flo199213/ShyGuy/Images/Back.jpg

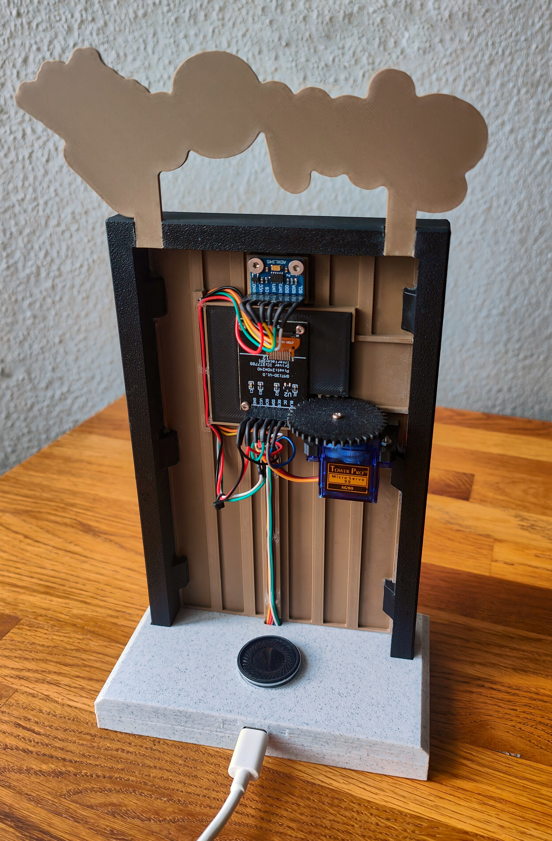
Images/Back.jpg
