flo199213/ShyGuy/Images/BackDetail.jpg

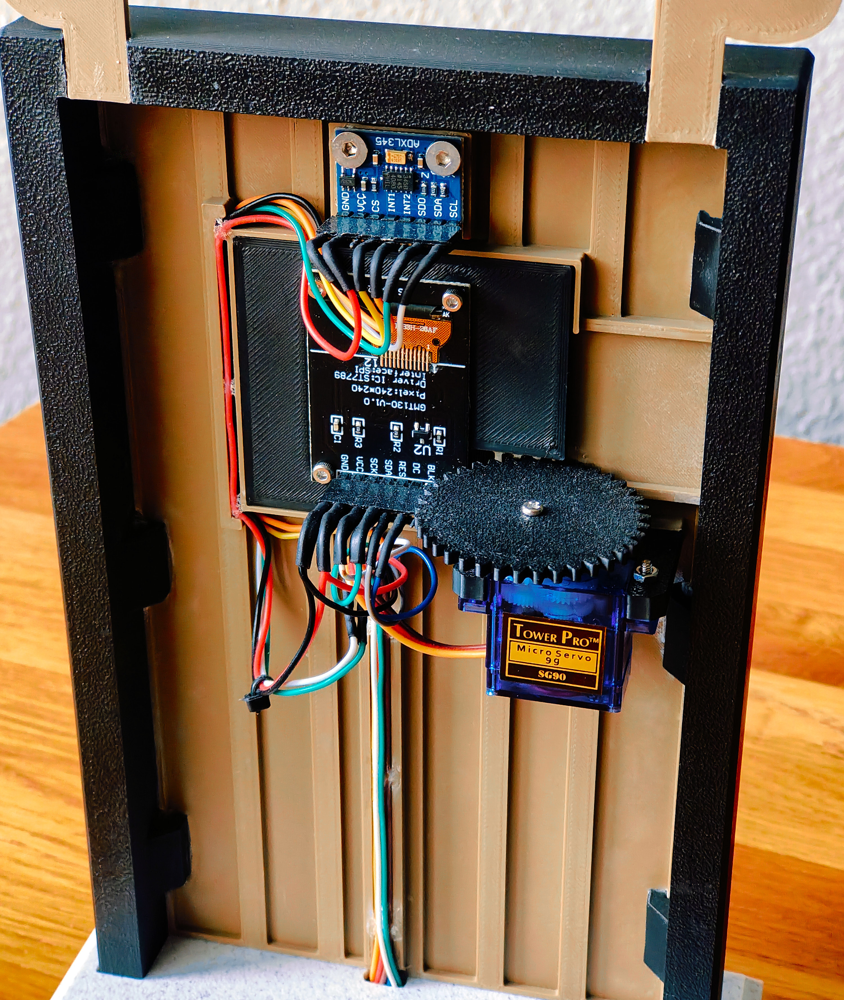
Images/BackDetail.jpg
