flo199213/ShyGuy/Images/Cults.jpg

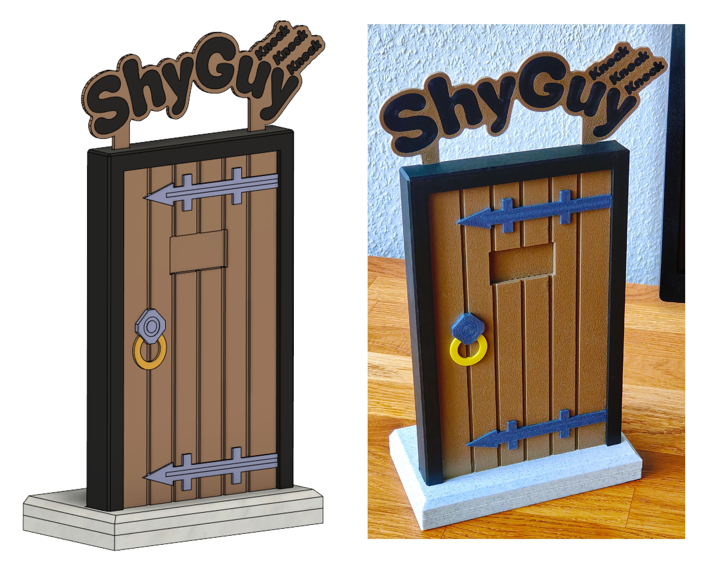
Images/Cults.jpg
