flo199213/ShyGuy/Images/Front.jpg

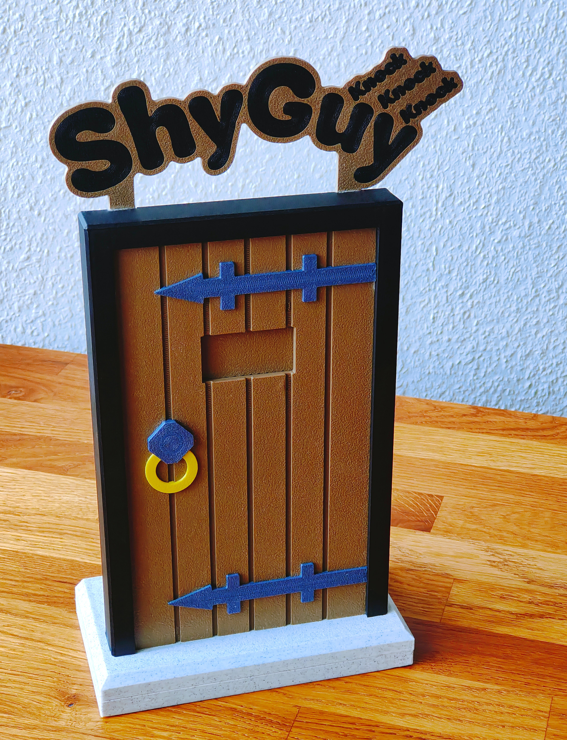
Images/Front.jpg
