flo199213/ShyGuy/Images/FrontWithMonitor2.jpg

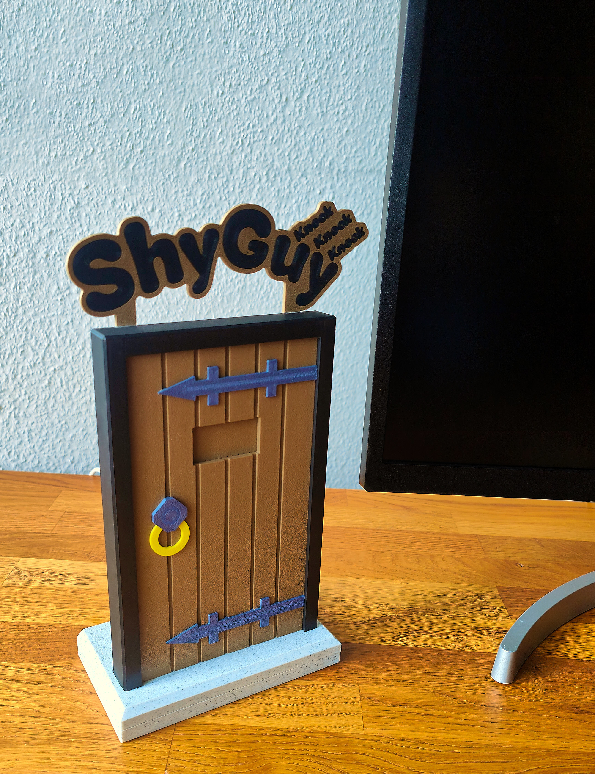
Images/FrontWithMonitor2.jpg
