flo199213/ShyGuy/Images/FrontWithMonitor.jpg

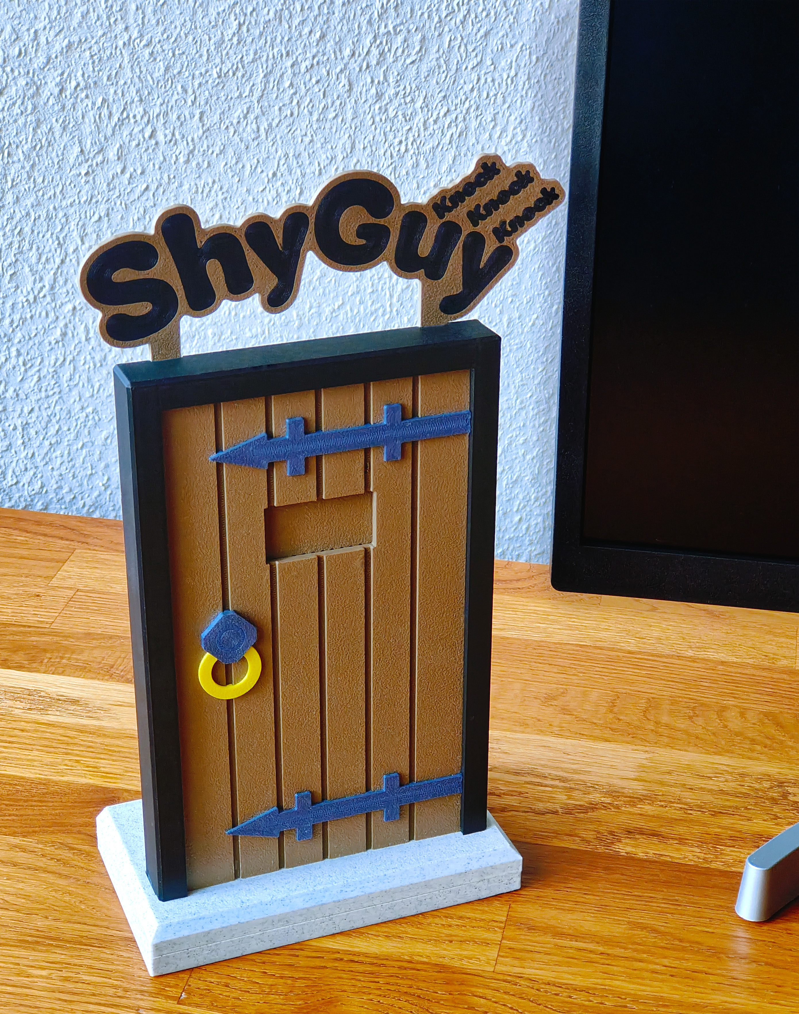
Images/FrontWithMonitor.jpg
