flo199213/ShyGuy/Images/Mechanism5.png

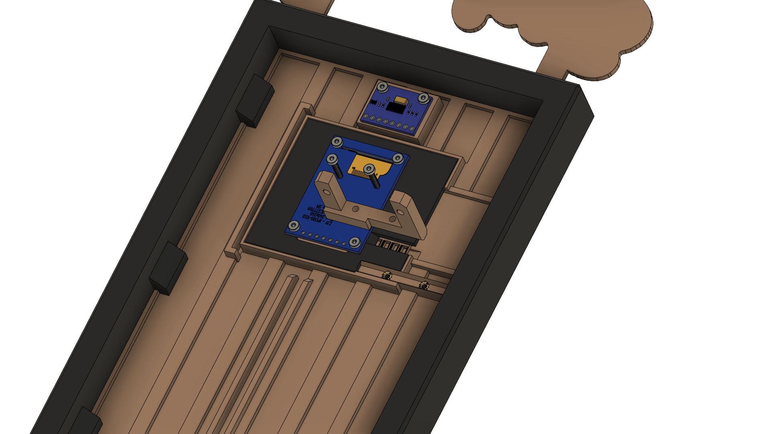
Images/Mechanism5.png
