flo199213/ShyGuy/Images/Mechanism6.png

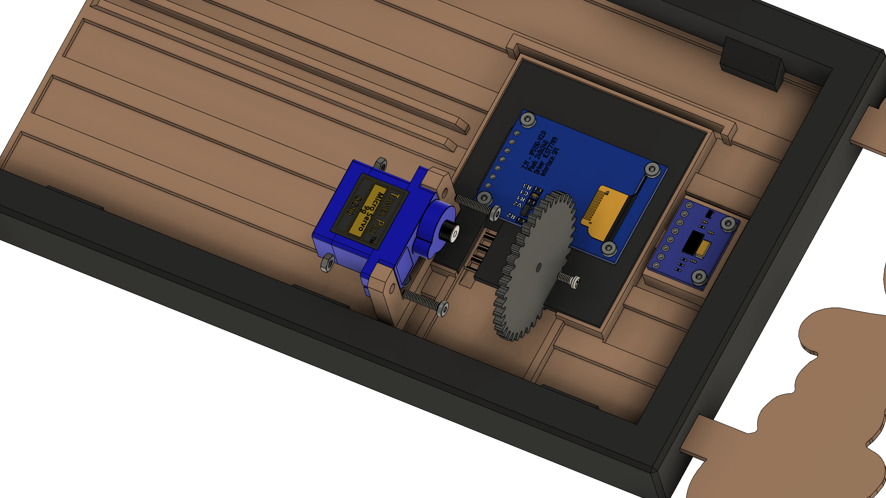
Images/Mechanism6.png
