flo199213/ShyGuy/Images/ShyGuyDoor v44.png

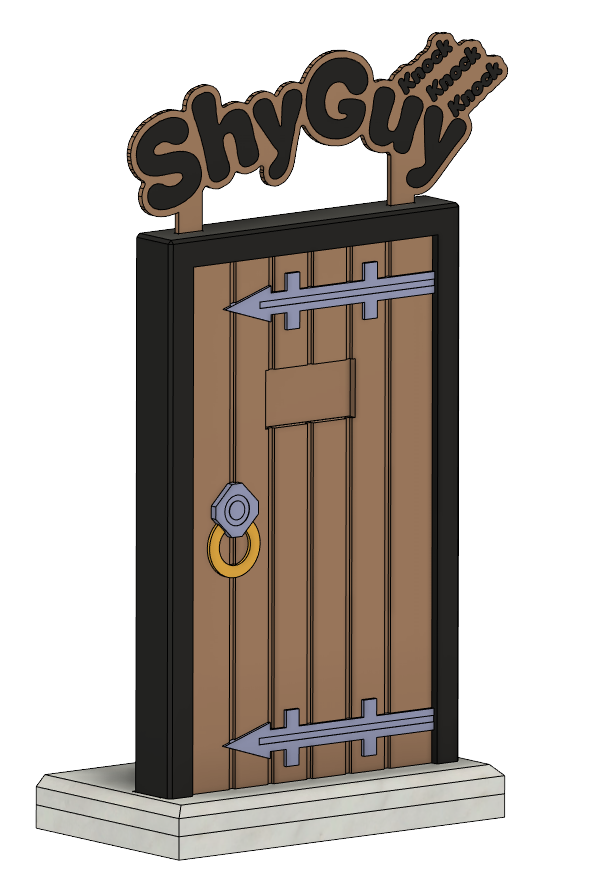
Images/ShyGuyDoor v44.png
