flo199213/ShyGuy/Images/ShyGuyDoor_Back.png

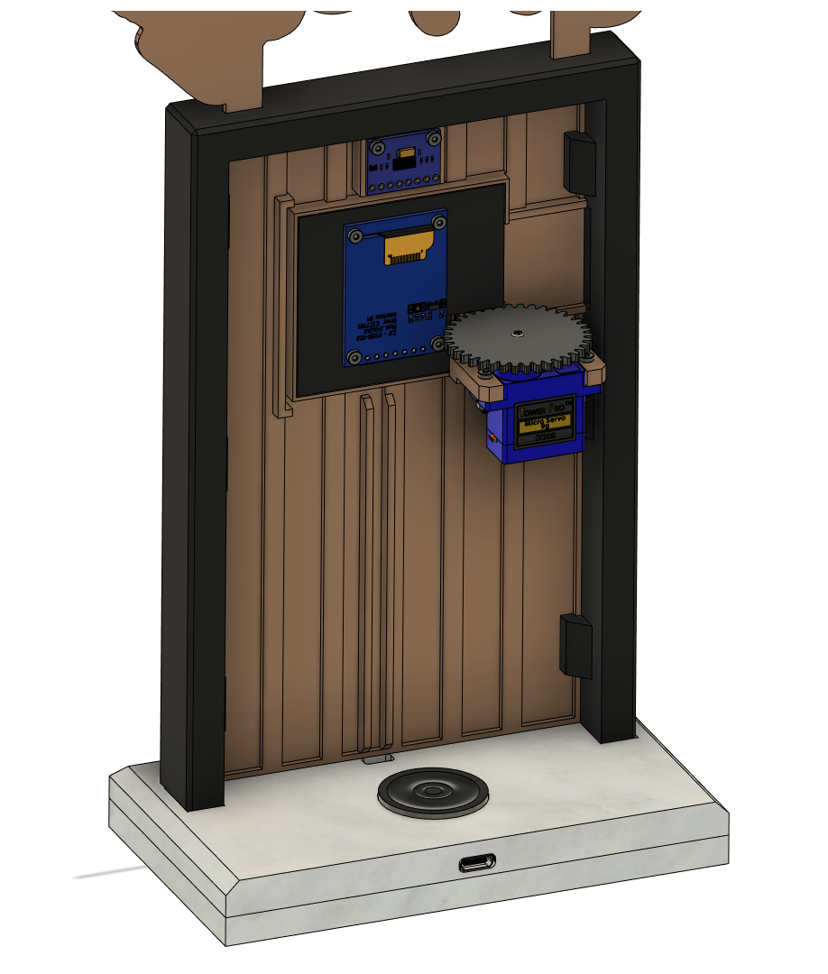
Images/ShyGuyDoor_Back.png
