flo199213/ShyGuy/Images/ShyGuyDoor_Mechanism.png

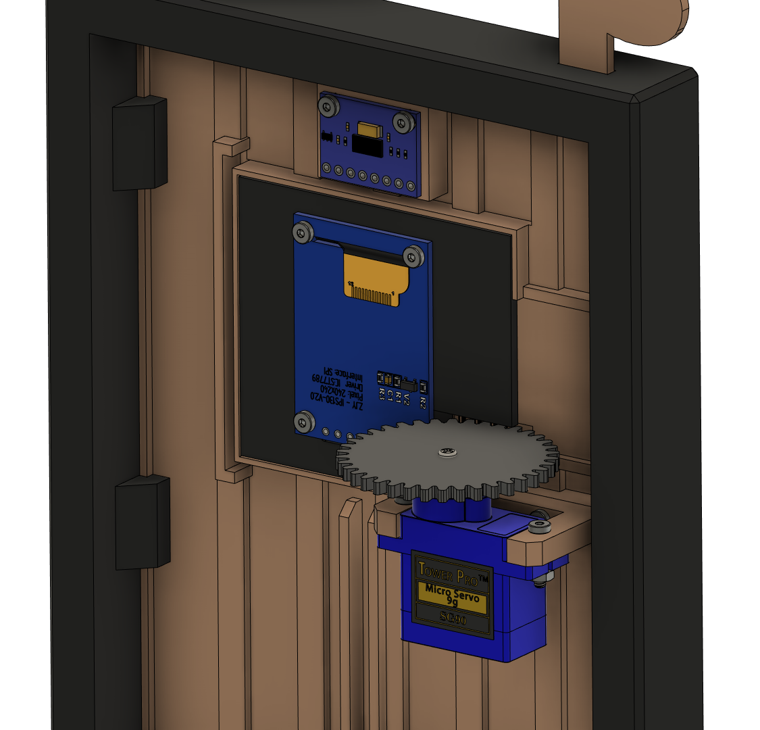
Images/ShyGuyDoor_Mechanism.png
