flo199213/ShyGuy/Images/ShyGuyDoorFront.png

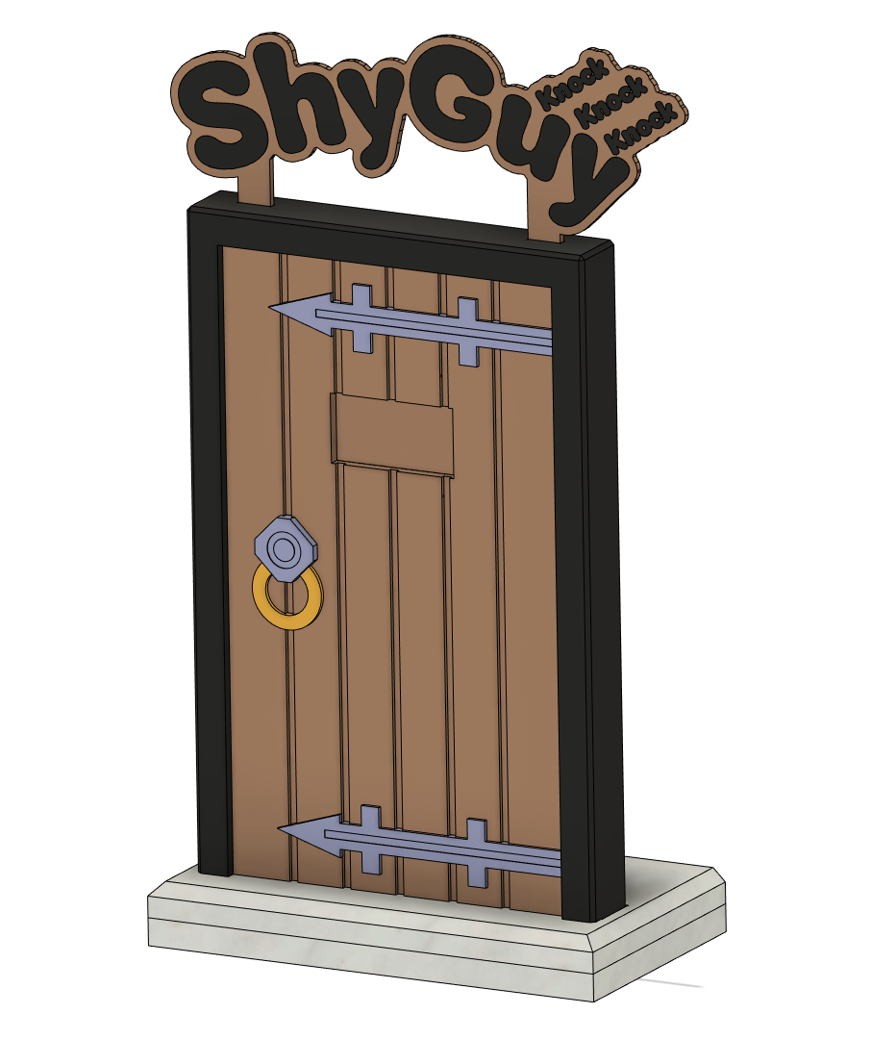
Images/ShyGuyDoorFront.png
