flo199213/ShyGuy/ESP32S2_ShyGuy/FaceEmotions.hpp

/***************************************************
Copyright (c) 2020 Luis Llamas
(www.luisllamas.es)

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
This program is distributed in the hope that it will be useful, but WITHOUT ANY WARRANTY; without even the implied warranty of MERCHANTABILITY or FITNESS FOR A PARTICULAR PURPOSE.  See the GNU Affero General Public License for more details.

You should have received a copy of the GNU Affero General Public License along with this program.  If not, see <http://www.gnu.org/licenses
****************************************************/

#ifndef FACEEMOTIONS_H
#define FACEEMOTIONS_H

#include <Arduino.h>
#include "Common.h"

enum eEmotions
{
	Normal = 0,
	Angry,
	Glee,
	Happy,
	Sad,
	Worried,
	Focused,
	Annoyed,
	Surprised,
	Skeptic,
	Frustrated,
	Unimpressed,
	Sleepy,
	Suspicious,
	Squint,
	Furious,
	Scared,
	Awe,
	EMOTIONS_COUNT
};

#endif
