flo199213/ShyGuy/ESP32S2_ShyGuy/sounddata_GoAway.h

// Wav2c recriado em Javascript por Guilherme Rodrigues: https://github.com/guilhermerodrigues680/wav2c-online
// Baseado no wav2c em C de Olle Jonsson: https://github.com/olleolleolle/wav2c

//const int sounddata_sampleRate = 48000; 
const int sounddata_length_Go_away = 33036;

unsigned char PROGMEM sounddata_data_Go_away[] = { 128,
128, 128, 128, 128, 128, 128, 128, 128, 128, 128, 128, 128, 128, 128, 127, 127, 127, 127, 127, 127,
127, 127, 127, 127, 127, 127, 127, 127, 127, 127, 127, 127, 126, 126, 126, 126, 126, 126, 125, 125,
125, 125, 125, 126, 126, 126, 126, 126, 127, 127, 127, 127, 127, 127, 127, 127, 127, 127, 128, 128,
128, 128, 129, 129, 129, 130, 130, 130, 130, 130, 130, 130, 130, 130, 130, 130, 131, 131, 131, 131,
131, 131, 131, 131, 130, 130, 129, 129, 129, 129, 128, 128, 128, 128, 128, 128, 128, 128, 128, 128,
127, 127, 127, 127, 127, 127, 127, 127, 127, 127, 127, 126, 126, 125, 125, 124, 123, 123, 122, 121,
120, 119, 119, 119, 119, 120, 121, 122, 123, 123, 124, 125, 125, 126, 126, 126, 126, 126, 126, 126,
127, 127, 128, 129, 130, 130, 131, 131, 132, 133, 134, 134, 134, 134, 134, 133, 134, 134, 134, 134,
134, 134, 134, 134, 134, 135, 134, 134, 133, 132, 131, 130, 129, 129, 128, 127, 127, 126, 126, 126,
126, 126, 127, 127, 127, 128, 128, 128, 128, 129, 129, 129, 129, 129, 128, 128, 127, 127, 126, 124,
123, 121, 119, 118, 115, 113, 111, 109, 109, 110, 112, 114, 116, 118, 119, 121, 123, 125, 126, 128,
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
130, 129, 128, 127, 126, 125, 125, 124, 124, 123, 123, 125, 129, 134, 138, 141, 144, 145, 146, 146,
145, 143, 141, 138, 134, 130, 124, 118, 113, 108, 103,  98,  92,  86,  79,  72,  68,  66,  69,  74,
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
