flo199213/ShyGuy/ESP32S2_ShyGuy/sounddata_Hey.h

// Wav2c recriado em Javascript por Guilherme Rodrigues: https://github.com/guilhermerodrigues680/wav2c-online
// Baseado no wav2c em C de Olle Jonsson: https://github.com/olleolleolle/wav2c

//const int sounddata_sampleRate = 48000; 
const int sounddata_length_Hey = 12822; 

unsigned char PROGMEM sounddata_data_Hey[] = { 128,
128, 128, 128, 128, 127, 128, 128, 128, 128, 128, 127, 127, 127, 127, 127, 127, 128, 128, 128, 128,
128, 128, 128, 127, 127, 127, 127, 127, 127, 128, 128, 128, 128, 128, 128, 127, 127, 127, 127, 127,
127, 127, 128, 128, 128, 128, 128, 128, 127, 127, 127, 128, 128, 128, 128, 127, 127, 127, 128, 128,
128, 128, 127, 127, 127, 127, 128, 128, 128, 127, 127, 127, 127, 127, 127, 127, 127, 127, 127, 128,
128, 128, 128, 128, 128, 128, 128, 128, 128, 128, 127, 127, 126, 127, 127, 128, 128, 128, 128, 128,
128, 128, 129, 128, 128, 127, 126, 126, 127, 127, 128, 128, 128, 128, 127, 127, 126, 127, 127, 128,
129, 129, 129, 128, 128, 128, 128, 128, 127, 127, 127, 126, 126, 126, 127, 127, 128, 128, 128, 128,
127, 127, 127, 127, 128, 128, 128, 128, 127, 127, 127, 128, 129, 130, 129, 128, 126, 125, 125, 126,
128, 129, 129, 129, 128, 127, 126, 126, 127, 127, 127, 126, 126, 127, 127, 129, 130, 131, 131, 130,
129, 127, 126, 125, 126, 127, 127, 128, 128, 128, 127, 127, 127, 127, 127, 128, 128, 127, 127, 127,
127, 128, 129, 129, 129, 128, 128, 127, 127, 127, 127, 127, 127, 128, 128, 128, 127, 126, 125, 125,
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
127, 131, 134, 135, 133, 129, 125, 124, 125, 127, 129, 131, 132, 131, 130, 129, 127, 125, 124, 125,
126, 128, 129, 128, 126, 125, 124, 125, 126, 127, 128, 129, 129, 127, 125, 124, 126, 128, 131, 133,
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
};
