flo199213/ShyGuy/ESP32S2_ShyGuy/EyePresets.h

/***************************************************
Copyright (c) 2023 Alastair Aitchison, Playful Technology, 2020 Luis Llamas (www.luisllamas.es)

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
This program is distributed in the hope that it will be useful, but WITHOUT ANY WARRANTY; without even the implied warranty of MERCHANTABILITY or FITNESS FOR A PARTICULAR PURPOSE.  See the GNU Affero General Public License for more details.

You should have received a copy of the GNU Affero General Public License along with this program.  If not, see <http://www.gnu.org/licenses 
****************************************************/

/**
 * EyePresets.h
 * Defines the eye config associated with each emotion
 */

#ifndef EYEPRESETS_H
#define EYEPRESETS_H

#include <Arduino.h>
#include "Common.h"
#include "EyeConfig.h"

static const EyeConfig Preset_Normal =
{
	.OffsetX = 0,
	.OffsetY = 0,
	.Height = 40,
	.Width = 40,
	.Slope_Top = 0,
	.Slope_Bottom = 0,
	.Radius_Top = 8,
	.Radius_Bottom = 8,
	.Inverse_Radius_Top = 0,
	.Inverse_Radius_Bottom = 0,
	.Inverse_Offset_Top = 0,
	.Inverse_Offset_Bottom = 0
};

static const EyeConfig Preset_Happy =
{
	.OffsetX = 0,
	.OffsetY = 0,
	.Height = 10,
	.Width = 40,
	.Slope_Top = 0,
	.Slope_Bottom = 0,
	.Radius_Top = 10,
	.Radius_Bottom = 0,
	.Inverse_Radius_Top = 0,
	.Inverse_Radius_Bottom = 0,
	.Inverse_Offset_Top = 0,
	.Inverse_Offset_Bottom = 0
};

static const EyeConfig Preset_Glee =
{
	.OffsetX = 0,
	.OffsetY = 0,
	.Height = 8,
	.Width = 40,
	.Slope_Top = 0,
	.Slope_Bottom = 0,
	.Radius_Top = 8,
	.Radius_Bottom = 0,
	.Inverse_Radius_Top = 0,
	.Inverse_Radius_Bottom = 5,
	.Inverse_Offset_Top = 0,
	.Inverse_Offset_Bottom = 0
};

static const EyeConfig Preset_Sad =
{
	.OffsetX = 0,
	.OffsetY = 0,
	.Height = 15,
	.Width = 40,
	.Slope_Top = -0.5,
	.Slope_Bottom = 0,
	.Radius_Top = 1,
	.Radius_Bottom = 10,
	.Inverse_Radius_Top = 0,
	.Inverse_Radius_Bottom = 0,
	.Inverse_Offset_Top = 0,
	.Inverse_Offset_Bottom = 0
};

static const EyeConfig Preset_Worried =
{
	.OffsetX = 0,
	.OffsetY = 0,
	.Height = 25,
	.Width = 40,
	.Slope_Top = -0.1,
	.Slope_Bottom = 0,
	.Radius_Top = 6,
	.Radius_Bottom = 10,
	.Inverse_Radius_Top = 0,
	.Inverse_Radius_Bottom = 0,
	.Inverse_Offset_Top = 0,
	.Inverse_Offset_Bottom = 0
};

static const EyeConfig Preset_Worried_Alt =
{
	.OffsetX = 0,
	.OffsetY = 0,
	.Height = 35,
	.Width = 40,
	.Slope_Top = -0.2,
	.Slope_Bottom = 0,
	.Radius_Top = 6,
	.Radius_Bottom = 10,
	.Inverse_Radius_Top = 0,
	.Inverse_Radius_Bottom = 0,
	.Inverse_Offset_Top = 0,
	.Inverse_Offset_Bottom = 0
};

static const EyeConfig Preset_Focused =
{
	.OffsetX = 0,
	.OffsetY = 0,
	.Height = 14,
	.Width = 40,
	.Slope_Top = 0.2,
	.Slope_Bottom = 0,
	.Radius_Top = 3,
	.Radius_Bottom = 1,
	.Inverse_Radius_Top = 0,
	.Inverse_Radius_Bottom = 0,
	.Inverse_Offset_Top = 0,
	.Inverse_Offset_Bottom = 0
};

static const EyeConfig Preset_Annoyed =
{
	.OffsetX = 0,
	.OffsetY = 0,
	.Height = 12,
	.Width = 40,
	.Slope_Top = 0,
	.Slope_Bottom = 0,
	.Radius_Top = 0,
	.Radius_Bottom = 10,
	.Inverse_Radius_Top = 0,
	.Inverse_Radius_Bottom = 0,
	.Inverse_Offset_Top = 0,
	.Inverse_Offset_Bottom = 0
};

static const EyeConfig Preset_Annoyed_Alt =
{
	.OffsetX = 0,
	.OffsetY = 0,
	.Height = 5,
	.Width = 40,
	.Slope_Top = 0,
	.Slope_Bottom = 0,
	.Radius_Top = 0,
	.Radius_Bottom = 4,
	.Inverse_Radius_Top = 0,
	.Inverse_Radius_Bottom = 0,
	.Inverse_Offset_Top = 0,
	.Inverse_Offset_Bottom = 0
};

static const EyeConfig Preset_Surprised =
{
	.OffsetX = -2,
	.OffsetY = 0,
	.Height = 45,
	.Width = 45,
	.Slope_Top = 0,
	.Slope_Bottom = 0,
	.Radius_Top = 16,
	.Radius_Bottom = 16,
	.Inverse_Radius_Top = 0,
	.Inverse_Radius_Bottom = 0,
	.Inverse_Offset_Top = 0,
	.Inverse_Offset_Bottom = 0
};

static const EyeConfig Preset_Skeptic =
{
	.OffsetX = 0,
	.OffsetY = 0,
	.Height = 40,
	.Width = 40,
	.Slope_Top = 0,
	.Slope_Bottom = 0,
	.Radius_Top = 10,
	.Radius_Bottom = 10,
	.Inverse_Radius_Top = 0,
	.Inverse_Radius_Bottom = 0,
	.Inverse_Offset_Top = 0,
	.Inverse_Offset_Bottom = 0
};

static const EyeConfig Preset_Skeptic_Alt =
{
	.OffsetX = 0,
	.OffsetY = -6,
	.Height = 26,
	.Width = 40,
	.Slope_Top = 0.3,
	.Slope_Bottom = 0,
	.Radius_Top = 1,
	.Radius_Bottom = 10,
	.Inverse_Radius_Top = 0,
	.Inverse_Radius_Bottom = 0,
	.Inverse_Offset_Top = 0,
	.Inverse_Offset_Bottom = 0
};

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
{
	.OffsetX = 2,
	.OffsetY = 0,
	.Height = 35,
	.Width = 45,
	.Slope_Top = -0.1,
	.Slope_Bottom = 0.1,
	.Radius_Top = 12,
	.Radius_Bottom = 12,
	.Inverse_Radius_Top = 0,
	.Inverse_Radius_Bottom = 0,
	.Inverse_Offset_Top = 0,
	.Inverse_Offset_Bottom = 0
};

#endif
