flo199213/ShyGuy/(notices)

Notices in the files:
ESP32S2_ShyGuy/Animations.h:
This program is free software: you can redistribute it and/or modify it under the terms of the GNU Affero General Public License as published by
the Free Software Foundation, either version 3 of the License, or (at your option) any later version.
ESP32S2_ShyGuy/ADXL345.h:
This program is free software: you can redistribute it and/or modify
it under the terms of the version 3 GNU General Public License as
published by the Free Software Foundation.
